unicef/DigitalDrum2.0/README.md

DigitalDrum2.0
==============
Digital Drum 2.0 by UNICEF and Design without Borders is licensed under a Creative Commons Attribution-ShareAlike 3.0 Unported License.
