unicef/DigitalDrum2.0/Digital Drum 2.0 Rev 0.1 _ Solar panel mounting.pdf

## Theftproof Mounting of Solar Panels on the roof

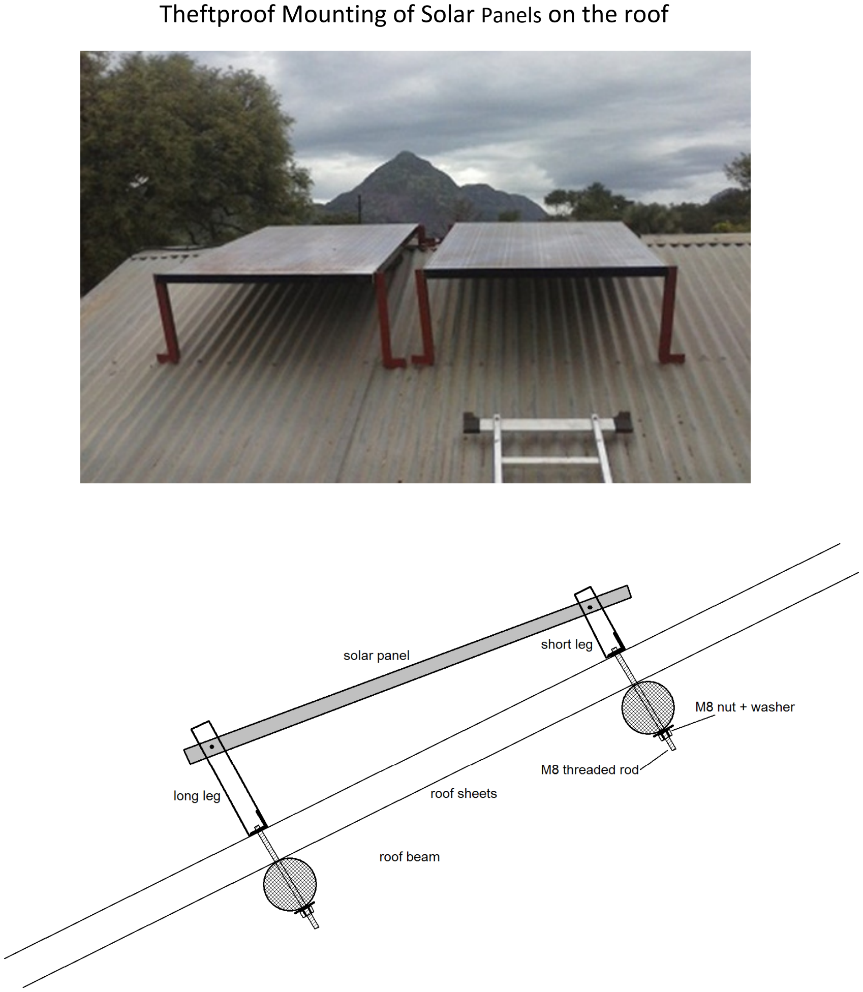
[picture p1: page 1]
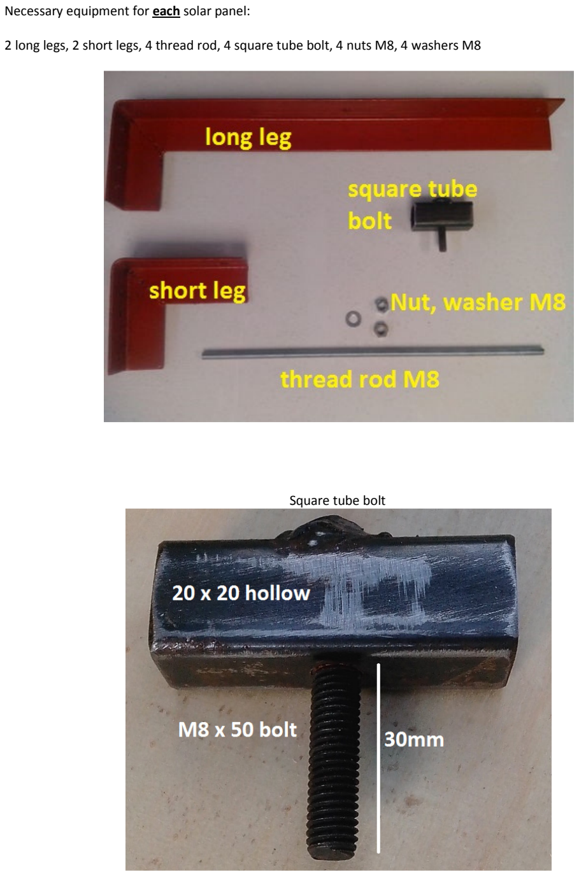
[picture p2: page 2]

Necessary equipment for each solar panel:

2 long legs, 2 short legs, 4 thread rod, 4 square tube bolt, 4 nuts M8, 4 washers M8

Square tube bolt

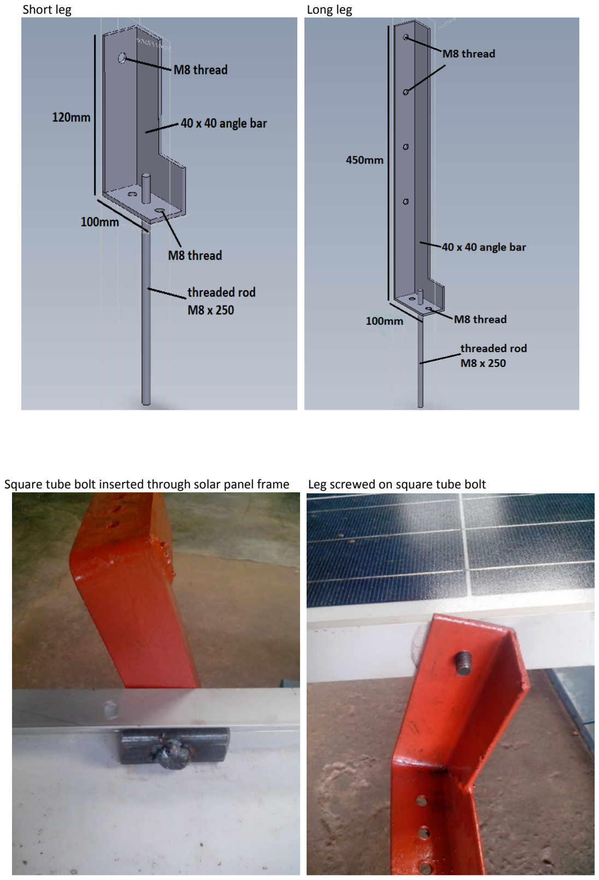
[picture p3: page 3]

Short leg | Long leg
Square tube bolt inserted through solar panel frame | Leg screwed on square tube bolt

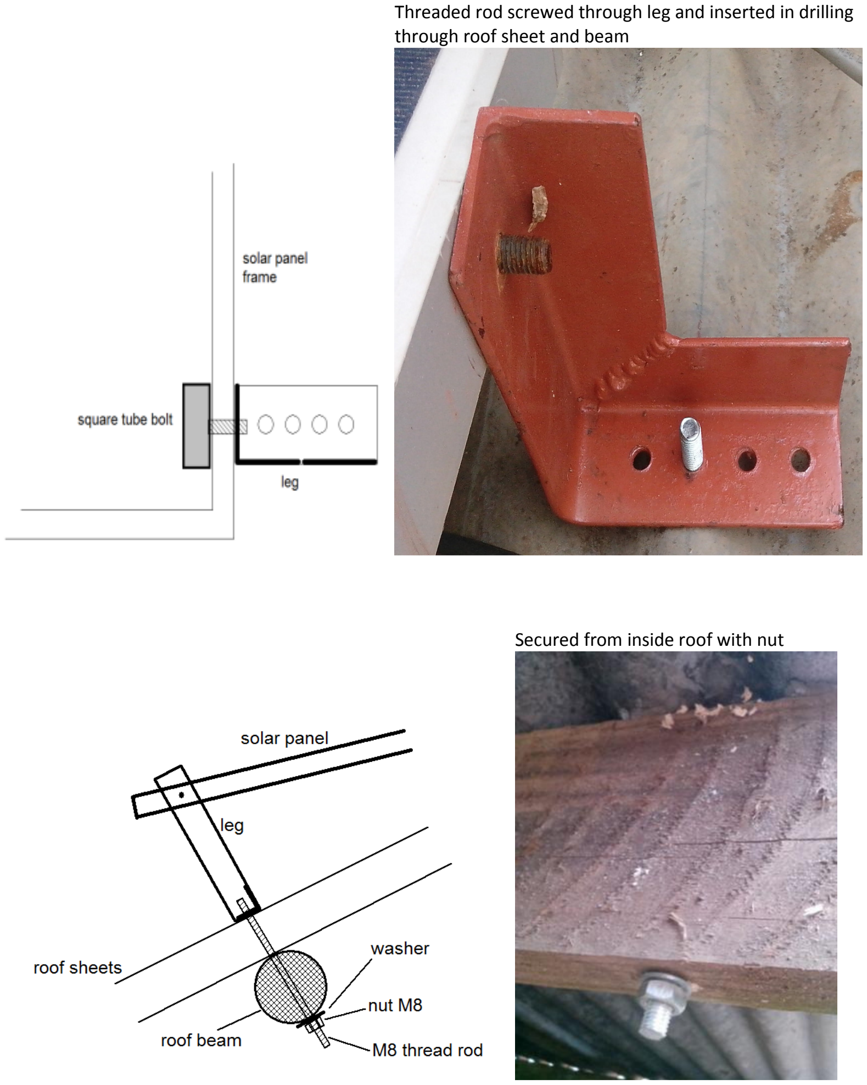
[picture p4: page 4]

Threaded rod screwed through leg and inserted in drilling through roof sheet and beam

Secured from inside roof with nut
