unicef/DigitalDrum2.0/Digital Drum 2.0 Rev 0.1 _ Bill of Materials.pdf

Digital Drum 2.0 by UNICEF and Design without Borders is licensed under a Creative Commons Attribution-ShareAlike 3.0 Unported License.

Date 14/9/2014, Rev 0.1 Code | Item description | Specification | Material | Reference drawing | Qty / Unit | Prototyping Supplier
001 | Oil Drum / Barrel | Standard 55 US gallon (208 liter) drum / barrel [machine work: 4x Ø12 holes + rectangular cut at bottom of drum. Cut-out for door. 4-8 Ø12 holes + Ø100 hole on top of drum] | Steel/ Powder Coated | Drum Complete.sldasm | 1
002 | Oil Drum Door | Included in Oil Drum Assembly | Steel/ Powder Coated | Drum Door Small.sldasm | 1
003 | Skeleton Structure, Lower part [TUBE, LOWER]. | Square, Hollow Steel Profile, 75x75mm, L=1200mm, t=2mm. [machined work: 6x Ø12 holes and 2 bigger cut-outs are to be machined on item. 2x M10 nuts are to be welded onto two of the holes.] ITEM 002 IS TO BE WELDED ONTO CENTER OF ITEM 004 | Carbon Steel Hot Formed/ Powder Coated | 75x75 Skeleton Beam w Stand _DETAILED.sldprt | 1 | http://www.roymech.co.uk/Useful_Tables/Sections/SHS_hf.html
004 | Skeleton Structure, [STEEL PLATE] | Steel Plate , 40x40cm , t=6mm. [machined work: 12x Ø12 holes to be drilled through plate, 4x M10 bolts to be welded onto plate] | Carbon Steel Hot Rolled/ Powder Coated | 6mm bottom steel plate.slddrw | 1
005 | Skeleton Structure, Upper part [TUBE, UPPER] | Square, Hollow Steel Profile, 65x65mm (60x60mm), L=1700mm, t=2mm. [machined work: 6x Ø6 holes and 3x Ø40 holes are to be drilled on this item] | Carbon Steel Hot Formed/ Powder Coated | 60x60 Upper Square Beam.sldprt | 1 | http://www.roymech.co.uk/Useful_Tables/Sections/SHS_hf.html
006 | Locking Pin | Ø10mm x 150mm | Stainless Steel | Drum Locking beam.slddrw | 1
007 | Table plate Hinges | Circular table plate, Diameter; min=1150mm, max=1200mm, Thickness; min=20mm, max=70mm Weight; less than 15kg. MUST BE HIGLY RESISTANT TOWARDS: water, termites, fire/heat, scratches, SURFACE needs to be very easy to clean/wipe, COLOR: a number of colors should be available, GENERAL RUGGEDDNES: a mass of 90kg should be able to stand anywhere on the table (when the table is fixed to the drum) without damage to the table metal hinge, door-type, (approx size of each «wing»: 40x100mm) fitted with at least 4 holes | Melamine and Resin | Table Unit _ MDF.slddrw | 1 | http://werzalit.com/de/tischplatten.html 008
| USB 3 Port Hub w/ Audio | (hole size = Ø3-Ø5mm) for screws/rivets, for drum door USB hub with at least 2 USB-ports + audio-output( mini-jack type) SIZE: Ø60 circular, | Stainless Steel | See Specification | 2 | http://www.amazon.com/Bolton-Radius-Steel-Nickel-Finish/dp/B000KZ9MGI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 009
| Washer, M10 | M10x 23mmX4.5 thick Extra thick washer DESIGN: for flash mounting into a plate/wall/table | N/A 18-8 Stainless | See Specification See Specification | 20 3 | http://www.voelkner.de/products/270817/3-Port-USB-2.0-Hub-Einbauhub- 60mm-Audio.html 010
| Wood Screws | Flat Head Phillips Self tapping L=15mm D=3-4mm | 18-8 Stainless | See Specification | 60 | http://www.amazon.com/Self-Tapping-Screws-Phillips-Stainless-http://www.boltdepot.com/Washers.aspx?nv=l 011
| Bolt | M10x30 Hex-Bolt / Machine Screw, stainless steel, | 305 Stainless | See Specification | 6 | htp://www.nutsandbolts.com/bolts-metric-hex-boltscap-screw-88-http://www.boltdepot.com/Metric_hex_bolts_Stainless_steel_18- 8_10mm_x_1.5mm.aspx 013
| Bolt | M10x40 Hex-Bolt / Machine Screw, stainless steel, | 306 Stainless | See Specification | 6 | coarse-c-31_162.html?page=1&sort=20a 014
| Bolt Nut Nut, Anti-theft screws [public screen + Odroids] | Cotytech Screws M5x20 Hex-Bolt / Machine Screw, stainless steel, M10 Hex-Nut, stainless steel, M5 Hex-Nut, stainless steel, | 307 Stainless 308 Stainless 309 Stainless Stainless Steel | DIN 912 M4x30.sldprt See Specification See Specification See Specification | 24 20 10 4 | http://www.boltdepot.com/Metric_hex_nuts_Stainless_steel_18-8.aspx 017 https://www.boltdepot.com/Metric_tap_bolts_Stainless_steel_18- 8_5mm_x_0.8mm.aspx 016 http://www.boltdepot.com/Hex_nuts_Stainless_steel_18-8.aspx 018 http://www.cotytech.com/ content-product_info/product_id-31_162.html?page=1&sort=20a 015
Bolt | M10x100 Hex-Bolt / Machine Screw, stainless steel, | 304 Stainless | See Specification | 8 | Carton/dp/B0012ZMLOK 012

http://www.nutsandbolts.com/bolts-metric-hex-boltscap-screw-88-coarse-c-

1947/anti_theft_screws_for_cotytech_monitor_mounts.html 019 | Steel profiles, angled, wall mount/support _LOWER | Steel Profile, 80x80mm [bend to 80 degree angle, t=3mm, 3x Ø4 + 2x Ø10 holes in each] | Stainless Steel | Angled Steel Bar _ wall support.sldprt | 6 | Fabricator 020 | Monitor Clamp | Steel Profile, flat 40x450mm , t=1.5mm [2x Ø4 holes for wood screws] | Stainless Steel | Monitor clamp t=1.5.sldprt | 3 | Fabricator 021 | Speaker Clamp | Steel Profile, t=1.5mm, 40x300mm [4x 90degree bends, 2x Ø4 holes for wood screws] | Stainless Steel | 60X70 loudspeaker clamp.sldprt | 4 | Fabricator

Code | Webcam Clamp Steel bar [public speaker mount] Dividing Wall Item description | Steel profile, flat 40x100mm, t=1.5mm [2x Ø4 holes for wood screws] Steel Profile, 40x400mm [2x 90degree bends, t=1.5mm, 2x Ø4 holes for wood screws] Plywood plate (MDF might also be an option) 100x90cm, t=16-20mm [machine works: cuts Specification | Stainless Steel Stainless Steel Material | webcam_clamp t=1.5.sldprt Reference drawing | Qty / Unit 3 1 | Prototyping Supplier 022 Fabricator 023 Fabricator 024
| Screen Protection, workstation | on bot sides, rectangular cut-out, 1x Ø60 hole, 1x Ø40 hole, 1x Ø20 hole] SCRATCHPROOF Plexiglas plate, 450x300mm, t=4-5mm | Foamed PVC Polycarbonate | Wall_Mount_Protection Tilted.slddrw PlexiCover_Flat_Gechic16.slddrw | 3 3 | http://www.plexiglas-shop.com/DE/en/sheet/plexiglas-resist-http://www.sdplastics.com/komatex.html 025
| Screen Protection, public screen | Plexiglas plate, t=3-5mm, 436x305mm | Polycarbonate | Public Screen Elliptic Cover.sldprt | 1 | http://www.plexiglas-shop.com/DE/en/sheet/plexiglas-resist-iq6052gfx0r.html 026
| Flexible Mount, Public Screen Padlock | Rugged steel padlock, diameter of U: min = 4mm, max = 6mm | Steel/Powder coated Stainless Steel | See Specification See Specification | 1 3 | iq6052gfx0r.html 027 http://www.walmart.com/ip/Master-Lock-141T-2-Count-1-9-16-in-Brass-http://monmount.com/tv-wall-mounts/lcd-1700/ 028

Weatherproof-Padlock/19870177?ci_src=14110944&ci_sku=19870177&sourceid=15000000
00000003260430 029 | Padlock Mount | mount/bracket for using padlock on drum-door | Stainless Steel | See Specification | 2 | http://www.amazon.com/Amico-Garage-Silver-Stainless-
Webcam | USB, 1 Megapixel. Integrated microphone input via USB (compatible with Linux OS) | N/A | See Specification | 3 | Padlock/dp/B008ATEV4E/ref=sr_1_10?ie=UTF8&qid=1396970143&sr=8-10&keywords=padlock+mount 030
Loudspeaker, workstation | Small PC speakers, max 2W power consumption per set, phono/minijack connection, USB- | | | | http://www.amazon.com/TeckNet%C2%AE-C016-Webcam-MegaPixel-Microphone/dp/B000Q3VECE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 031

powered

| | | N/A | See Specification | 2 http://www.amazon.com/dp/B00H4W1Z2E/ref=pe_385040_30332200_pe_30
9540_26725410_item
032 | Loudspeaker, public screen | Mid-size mono speaker, Max 5W power consumption, phono/minijack connection, NO battery N/A | See Specification | 1 | http://www.logitechshop.com.au/logitech-multimedia-speaker-z50-
free-delivery.html 033 | O-Droid X2 | Micro PC board. See specs in product link. | N/A | See Specification | 3 http://hardkernel.com/main/products/prdt_info.php?g_code=G13523561194
7 034 | SD Storage Card (Server) | 32GB SDHC Class 10 | N/A | See Specification | 1 | http://www.amazon.com/dp/B003VNKNF0/ref=cm_sw_su_dp 035 | Workstation display monitors | 15.6" [max power consumption = 8W, USB power input preferred, HDMI input (male), 1080p

support

N/A | See Specification | 3 | http://www.multicom.no/ON-LAP-portabel-15e6-monitore-silver-GeChic/cat-
p/c/p5430995 036 | Public display monitor | 19" [max power consumption = 15W, HDMI input (female), 1080p support | N/A | See Specification | 1 http://www.misco.co.uk/Product/208428/Cello-C22115F-22inch-LED-TV-with-
MicroHDMI > HDMI converter cable (M/F) Keyboards | Micro-size Type D to Full-size HDMI Type A (M/F) - Length: 6ft Standard 101-key+ USB keyboard | N/A N/A | See Specification See Specification | 2 3 | http://www.amazon.com/dp/B00EHKKZ9A/ref=cm_sw_su_dp 038 built-in-DVD-Player 037
Mice | 2-button USB laser/optical mouse with scroll wheel | N/A | See Specification | 3 | http://www.amazon.com/Audiovox-TPH510-Compact-Keyboard-Black/dp/B003KVZGE6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 63 039
HDMI 1x2 Splitter | 1 input 2 output (F/F/F) powered HDMI splitter. For split-screen public monitor solution | | | | http://www.amazon.com/AmazonBasics-3-Button-Wired-Mouse-Black/dp/B005EJH6RW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 040
SD Storage Card (Workstations) Network switch | (GeChic + Public HDMI Monitor) 8GB SDHC Class 10 Minimum 3x 100Mbps Ethernet ports (Max Power Consumption 2.5W) | N/A N/A N/A | See Specification See Specification See Specification | 1 2 1 | http://www.amazon.com/Splitter-Amplifier-Display-enable-certificated/dp/B007K1KWTQ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 042 16468&sr=1- 6&keywords=hdmi+splitter+1+in+2+out+1080p 041

http://www.amazon.com/TRENDnet-Unmanaged-GREENnet-Ethernet-TE100-S5/dp/B000M2TAN4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
r=1- 7&keywords=ethernet + switch 043 | MicroHDMI > HDMI converter cable (M/M) | Micro-size Type D to Full-size HDMI Type A (M/M) - Length: 1ft. For split-screen public

monitor solution (GeChic + Public HDMI Monitor)

| | | N/A | See Specification | 1

http://www.amazon.com/Bargain-Cable-FEET-Micro-Insignia/dp/B00J3CNN46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
72&sr=1-89&keywords=hdmi+cable+micro 044 | Network cables | Shielded CAT5 or CAT6 with RJ45 termination (straight configuration) - Length: 1 foot | N/A | See Specification | 3
| HDMI cable (2m) (M/M) | Full-size HDMI (M/M) - Length: 1.8 meters. For split-screen public monitor solution (GeChic + | | | | http://amzn.com/B004U29D8E 045
| Top Cap | Top cape to hold walls and table locked in place 5mm | Carbon Steel Hot Rolled/ Powder Coated | Top Lid _ metal.sldprt | 1 | 2&sr=1- 1&keywords=hdmi+cable+6+ft 046
047 | solar panel | 120Wp , Voc 19-22V, Vmpp 16-18V | N/A | | 2
048 | solar charge controller | 12V, 20A, with Datalogging connector to PC USB input | N/A | | 1 | http://www.phocos.com/datasheet_sm_cx.html

Public HDMI Monitor)

N/A | See Specification | 1

http://www.amazon.com/AmazonBasics-High-Speed-HDMI-Cable-Meters/dp/B003L1ZYYM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

Code | Item description | Specification | Material | Reference drawing | Qty / Unit | Prototyping Supplier 049 | copper bus bar terminal | with 6-8 screw terminals | Copper | 2 | http://www.ebay.com/itm/Din-Rail-7-Way-Terminal-Mains-230-400v- Busbar-Earth-Neutral-used-with-MCB-RCD-
| single wire | 10mm, flexible, red | PVC/ Copper | 1 | /331299450786?pt=UK_BOI_Electrical_Components_Supplies_ET&var =&hash=item4d22fc6fa2 050
051 | single wire | 10mm, flexible, black | PVC/ Copper | 1
052 | single wire | 2,5mm, flexible, red | PVC/ Copper | 3
053 | single wire | 2,5mm, flexible, black | PVC/ Copper | 3
054 | cable | 2x10mm , flexible, UV resistant | PVC/ Copper | 12
055 | battery | solar battery (deep cycle), Gel or AGM, 12V / 100Ah | N/A | 1
056 | wire connector cable ties | connector strip, size for 2x10mm wire nylon, 100mm | Copper Nylon | 1 40 | http://www.ebay.com/itm/10-lock-12-pin-terminal-block-4-5-mm-5A-luster-terminals-black-strips-/321455602412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 83f3aec 057
058 | cable ties | nylon, 300mm | Nylon | | 20
059 | Electronics Mounting board | plywood 15mm, 40x30cm | Plywood/ Foamed PVC | | 1
060 | woodscrews | 15mm | 304 Stainless | | 20
061 | DIN Rail | omega rail, for mounting of circuit breaker | Steel | | 0,2 http://www.ebay.com/itm/5-Piece-0-5-Meter-Aluminum-U-Groove- Slotted-DIN-Rail-For-C45-Switch-Meter-
| PV long leg mount | angle bar, 40x40mm, long leg | Carbon Steel Hot Formed/ | See Digital Drum 2.0 Rev 0.1 _ Solar panel mounting.pdf re. PV mounting | 4 | /281108032398?pt=LH_DefaultDomain_0&hash=item4173582b8e 062
063 | PV Short Leg mounts | angle bar, 40x40mm | Carbon Steel Hot Formed/ | | 4
064 | PV mount Bolt | square section bolt M8x 50mm | Zinc Plated Steel | 8
065 | PV mount Sub Frame | angle bar, 40x40mm | Zinc Plated Steel | 1
066 | PV mount Threaded Rod | M8 x 25cm. | Zinc Plated Steel | 8
067 | Nut | Nut M8 | Zinc Plated Steel | 16
068 | Washer | washer M8 | Zinc Plated Steel | 16
069 | rubber grommet [hole-liner] audio splitter, phono-minijack | to reduce stress on cables going through walls [mouse + keyboard], size: should cover a Ø2,5cm hole to facilitate speakers PLUS headset use | Buna-N N/A | 3 3 | http://www.amazon.com/Rig-Rite-Manufacturing-610-http://www.amazon.com/gp/product/B00009WQSR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 070
| Metal Edge Rubber Liner [to avoid sharp metal edges on drum-door and | | | | _i01?ie=UTF8&psc=1 071
Power switch also to seal door] | L=10ft/2,5m, must fit metal plate thickness t=1,5mm turn switch, industrial standard size 22.5mm, 1 no contact | N/A | 1 | http://www.mcmaster.com/#8451a91/=rh4g3j 072
Bolt, Carriage type, | | | 1 | http://www.voelkner.de/products/310664/Drehschalter-250-V-AC-5-A-Schaltpositionen-2-1-x-90-LAS0-A3Y-11X-23-IP40-1-St..html 073
DC-DC Converter | Stainless steel 18-8, #10 (3/16)-24 x 1" 10-60V to 5V conversion, 100W | 304 Stainless Steel N/A | 4 1 | http://www.boltdepot.com/Product-Details.aspx?product=12206 074
Charge controller Data Logger cable | PL2303HX USB To TTL To UART RS232 COM Cable Module Converter | N/A | 1 | http://www.mini-box.com/DCDC-USB incl. housing: http://www.mini-box.com/DCDC-USB-ENCLOSURE?sc=8&category=981 075
