unicef/DigitalDrum2.0/Digital Kiosk 2.0 Design demo.SLDASM

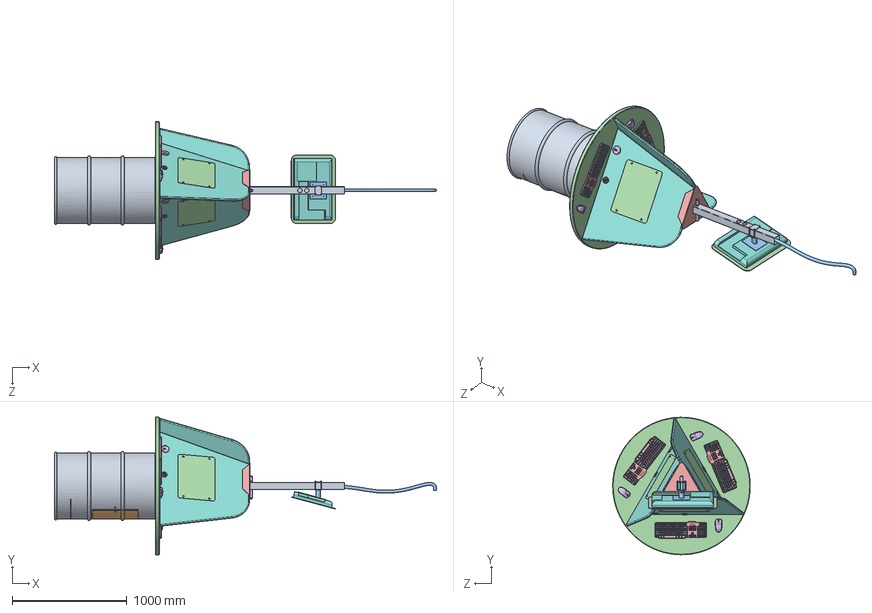
[picture p5: CAD file, 2014-09-26]
Digital Kiosk 2.0 Design demo.SLDASM
3331.8 x 1199.7 x 1199.6 mm
Drum Base Unit Small Door
Half Oil Drum w WindowCut
Battery x 2
75x75 Skeleton Beam w Stand
60x60 Upper Square Beam
Rubber Egde Liner 60x60 tube
Power Cable_Main
Mother Board Plate RECTANGULAR KIOSK 2.0
Charge Controller _ STECA
Morningstar RD1
Inverter RoughSketch 12_230V
Circuit Breaker x 2
Relay_Unit
Rail for Circ Breakers
Cable_Copper_Rail x 2
Table Unit _ MDF
User Library-DELL Keyboard x 3
Mouse 2 x 3
Logitech Speaker Z50
Wall_Mount_Protection Tilted x 3
Odroid-x2 x 3
Gechic16 x 3
PC Speaker 70x70 x 6
PlexiCover_Flat_Gechic16 x 3
Webcam_Circular x 3
Ø60 USB_accesspoint_BODY x 3
Rubber Rig Grommet 1inch x 3
O-ring Ø3 Silicone x 3
Carriage Bolt w Square neck 5mm L=25mm x 12
Angled Steel Bar _ wall support x 6
60X70 loudspeaker clamp x 6
User Library-Nut M06 x 12
webcam_clamp t=1.5 x 3
Gechic clamp t=1.5 x 3
woodscrew_din7997_2_5x10_st_h x 30
MonMount Wall _ backplate
din 912M6X70 x 4
MonMount Wall _ VESApiece
Public Screen Elliptic Cover
Top Lid _ metal
Drum Locking beam
