unicef/DigitalDrum2.0/reference_drawings/Drum Door Small.SLDASM

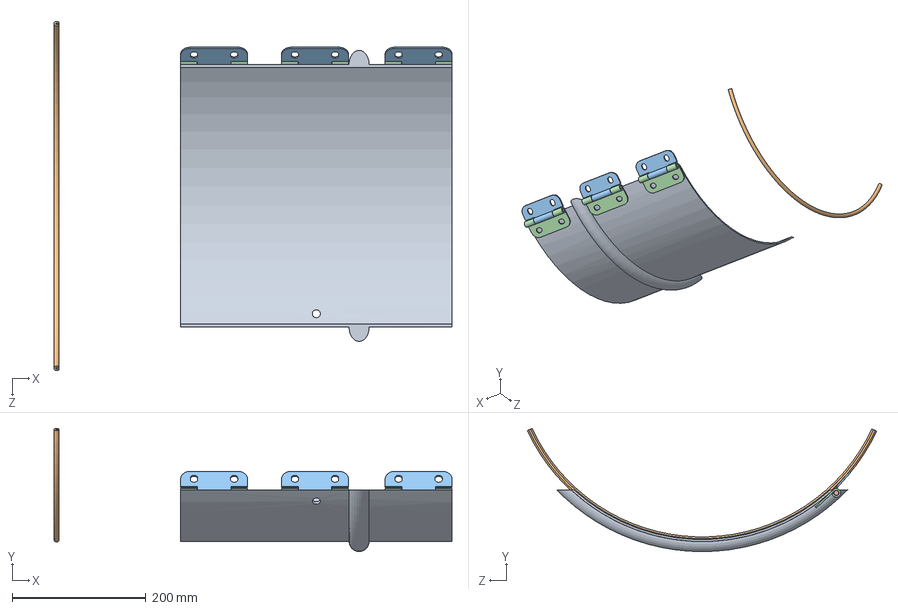
[picture p6: CAD file, 2014-09-26]
reference_drawings/Drum Door Small.SLDASM
595.5 x 184.3 x 522.9 mm
Half Oil Drum w WindowCut
