unicef/DigitalDrum2.0/reference_drawings/Drum Complete.SLDASM

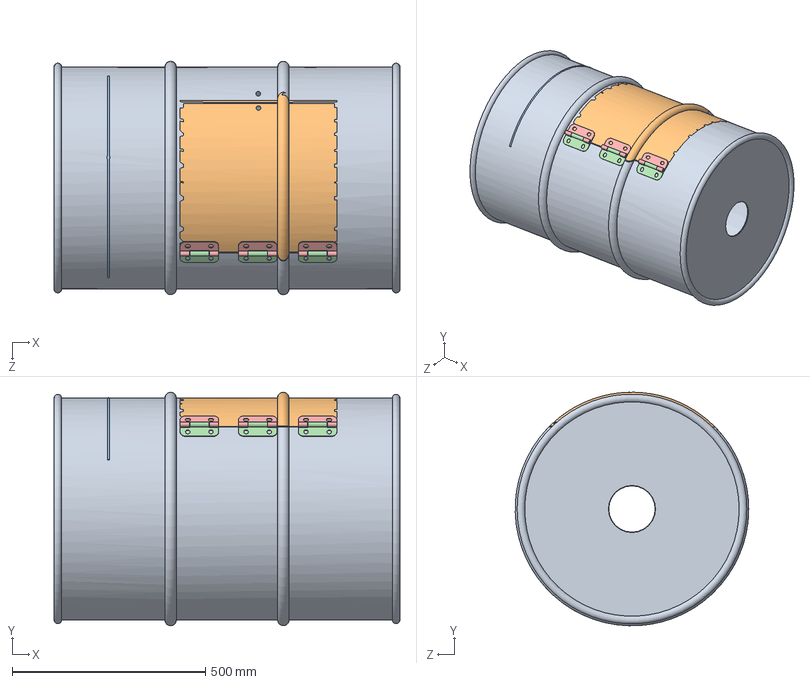
[picture p7: CAD file, 2014-09-26]
reference_drawings/Drum Complete.SLDASM
896.0 x 604.8 x 604.8 mm
Drum Base Unit Small Door
Half Oil Drum w WindowCut
