unicef/DigitalDrum2.0/reference_drawings/Top Lid _ metal.SLDPRT

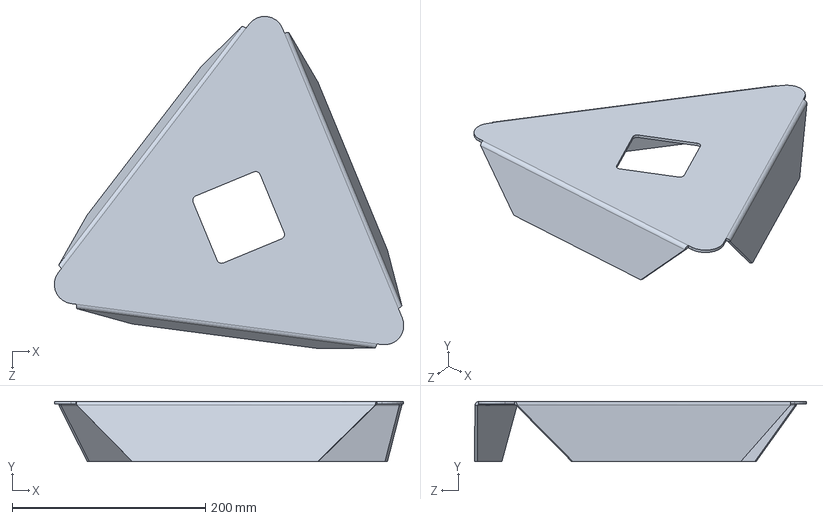
[picture p8: CAD file, 2014-09-26]
reference_drawings/Top Lid _ metal.SLDPRT
361.5 x 62.4 x 343.4 mm
