unicef/DigitalDrum2.0/reference_drawings/Public Screen Elliptic Cover.SLDPRT

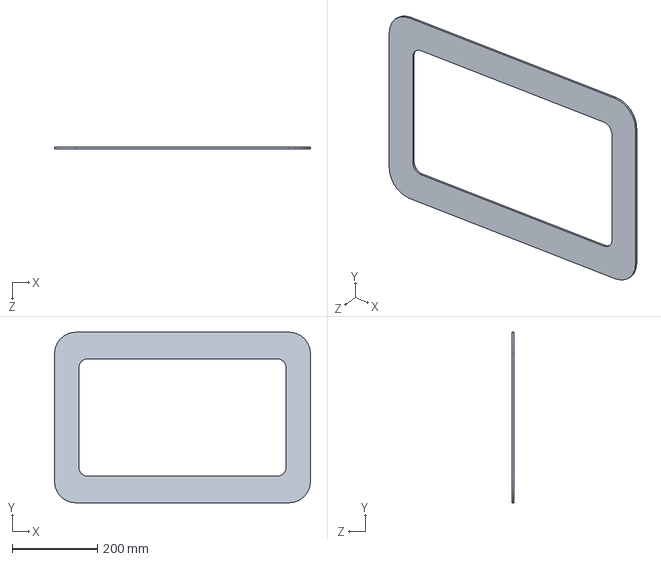
[picture p9: CAD file, 2014-09-26]
reference_drawings/Public Screen Elliptic Cover.SLDPRT
600.0 x 400.0 x 4.00 mm
