unicef/DigitalDrum2.0/reference_drawings/60x60 Upper Square Beam.SLDPRT

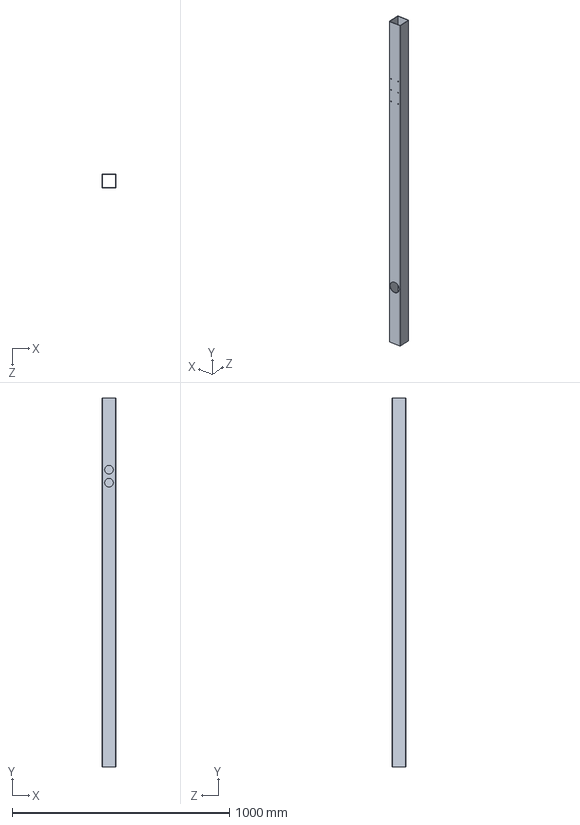
[picture p10: CAD file, 2014-09-26]
reference_drawings/60x60 Upper Square Beam.SLDPRT
65.0 x 1700.0 x 65.0 mm
