unicef/DigitalDrum2.0/reference_drawings/60X70 loudspeaker clamp.SLDPRT

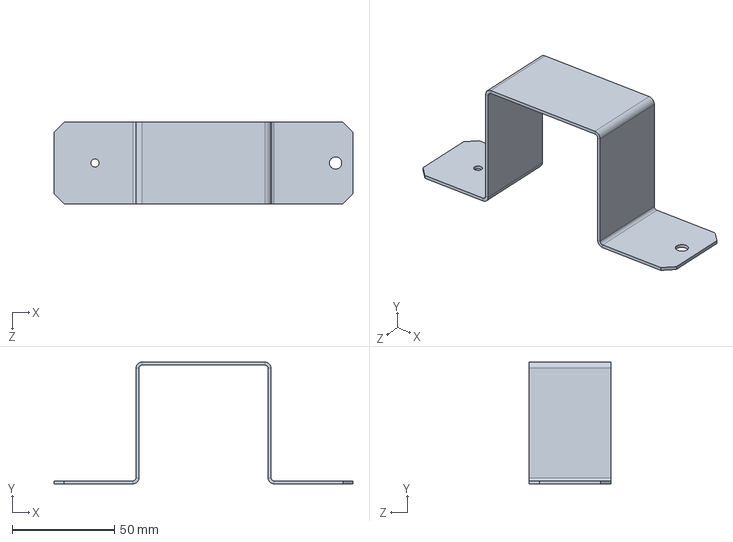
[picture p11: CAD file, 2014-09-26]
reference_drawings/60X70 loudspeaker clamp.SLDPRT
146.0 x 59.5 x 40.0 mm
