unicef/DigitalDrum2.0/reference_drawings/Monitor clamp t=1.5.SLDPRT

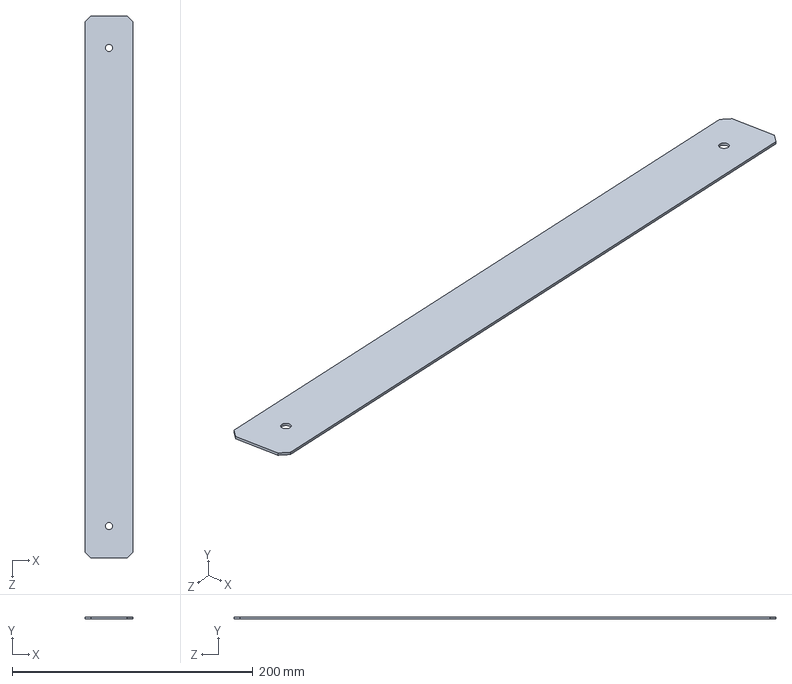
[picture p12: CAD file, 2014-09-26]
reference_drawings/Monitor clamp t=1.5.SLDPRT
40.0 x 1.50 x 450.0 mm
