unicef/DigitalDrum2.0/reference_drawings/webcam_clamp t=1.5.SLDPRT

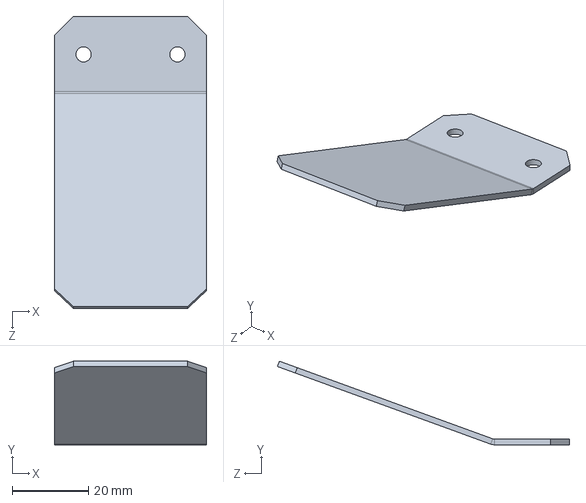
[picture p13: CAD file, 2014-09-26]
reference_drawings/webcam_clamp t=1.5.SLDPRT
40.0 x 22.0 x 76.9 mm
