unicef/DigitalDrum2.0/reference_drawings/Drum Locking beam.SLDPRT

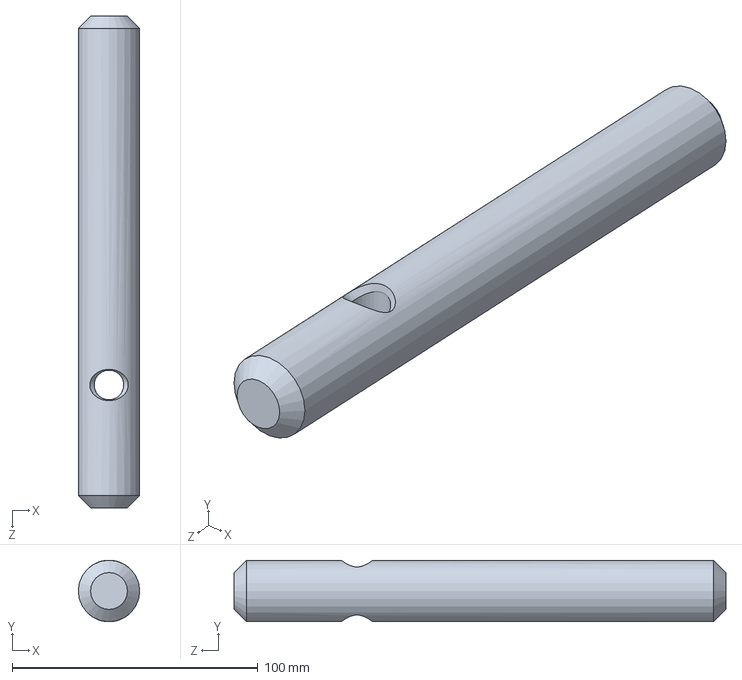
[picture p14: CAD file, 2014-09-26]
reference_drawings/Drum Locking beam.SLDPRT
25.0 x 25.0 x 200.0 mm
