unicef/DigitalDrum2.0/reference_drawings/Angled Steel Bar _ wall support.SLDPRT

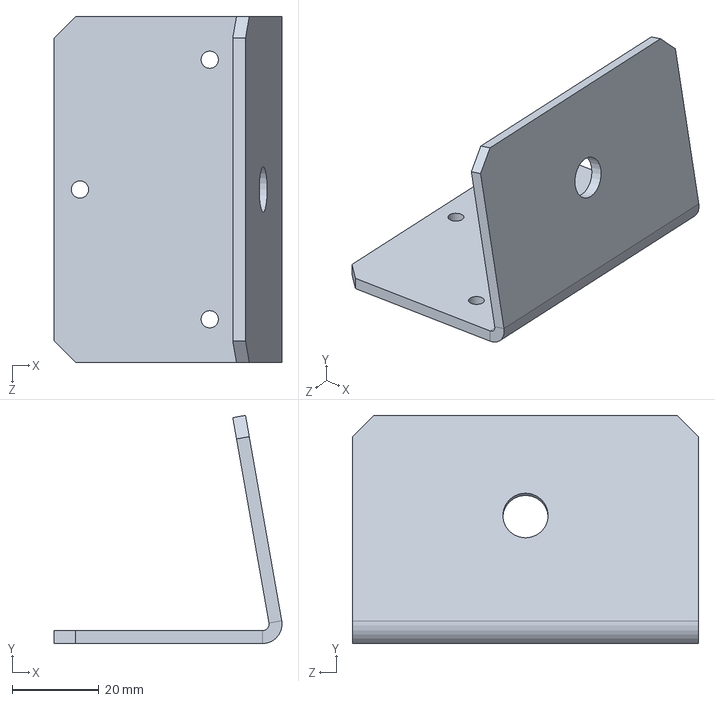
[picture p15: CAD file, 2014-09-26]
reference_drawings/Angled Steel Bar _ wall support.SLDPRT
52.7 x 52.8 x 80.0 mm
