unicef/DigitalDrum2.0/reference_drawings/DIN 912 M4x30.SLDPRT

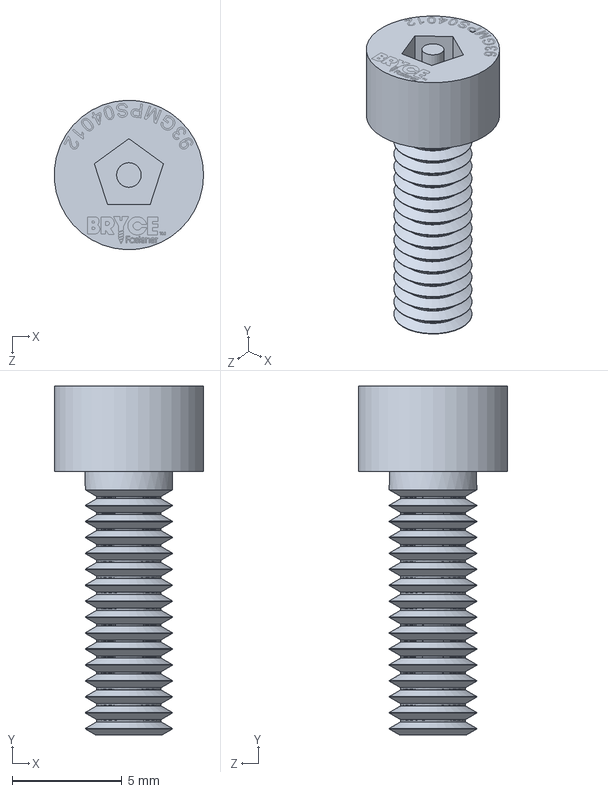
[picture p16: CAD file, 2014-09-26]
reference_drawings/DIN 912 M4x30.SLDPRT
6.79 x 15.9 x 6.79 mm
