unicef/DigitalDrum2.0/(list of files, cad)

Other CAD files:
reference_drawings/6mm bottom steel plate.SLDDRW
reference_drawings/75x75 Skeleton Beam w Stand _DETAILED.SLDDRW
reference_drawings/PlexiCover_Flat_Gechic16.SLDDRW
reference_drawings/Table Unit _ MDF.SLDDRW
reference_drawings/Wall_Mount_Protection Tilted.SLDDRW
reference_drawings/webcam_clamp t=1.5.SLDDRW
