unicef/DigitalDrum2.0/Digital Drum 2.0 Rev 0.1 _ Wiring diagram.pdf

## Digital drum 2.0. inst diagram, dc version

# headphone jack audio USB mic

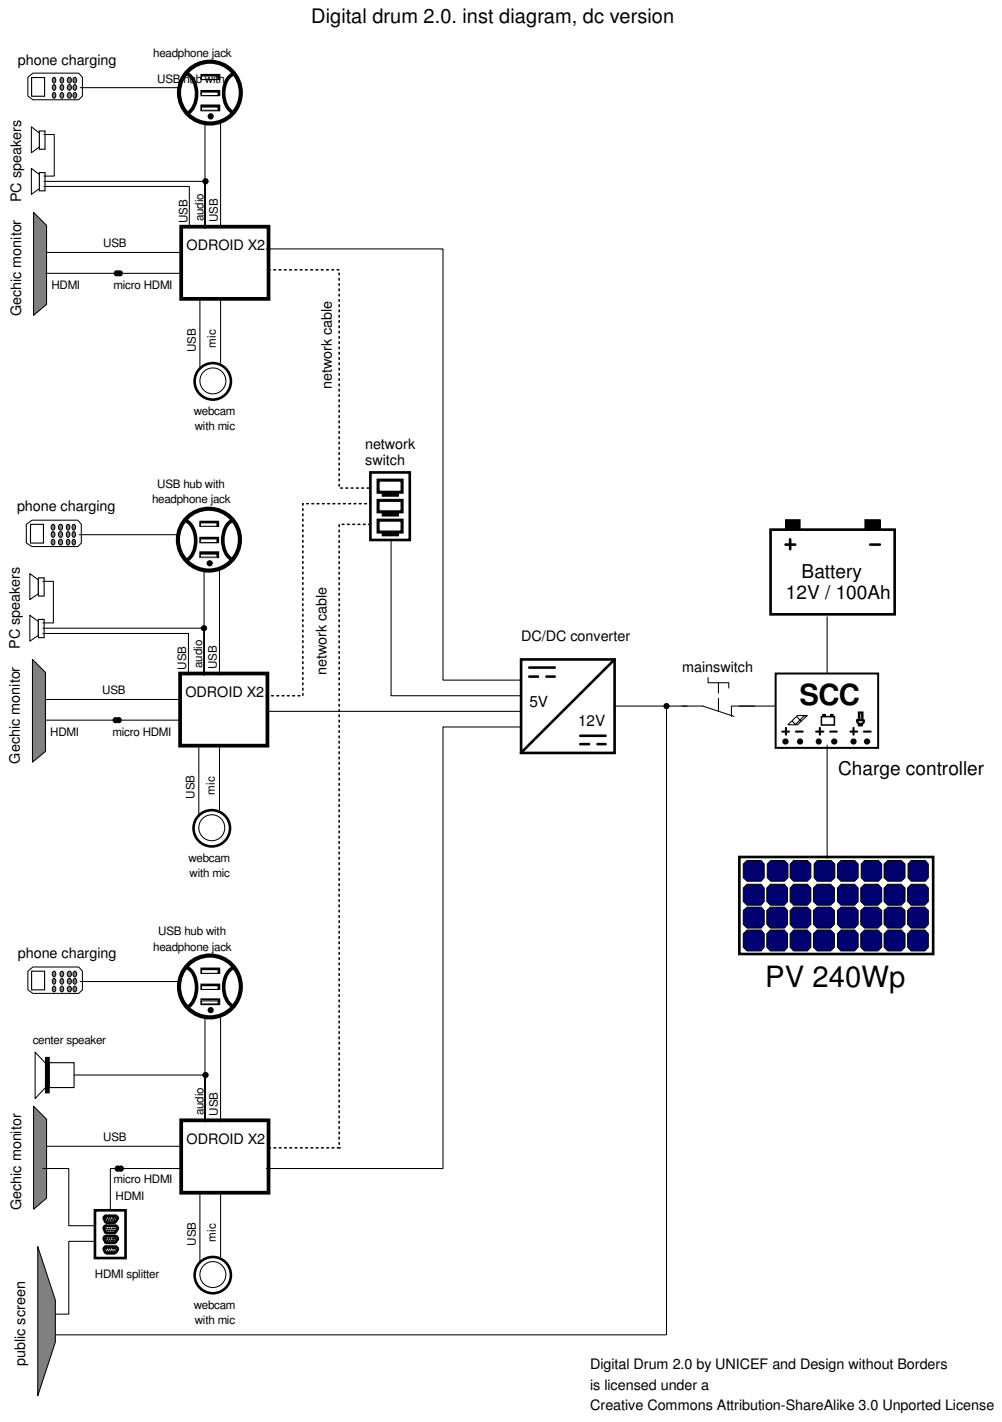
[picture p17: page 1]
phone charging; ODROID X2; SCC; Charge controller; center speaker; HDMI splitter; USB; HDMI; micro HDMI; webcam with mic; PC speakers; Gechic monitor; headphone jack audio USB; mic; webcam; network switch; Battery; mainswitch

USB hub with

Gechic monitor public screen

network cable

DC/DC converter

with mic USB

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
